KremerMichael/chen-lab-PCB/pictures/diff_amp.jpg

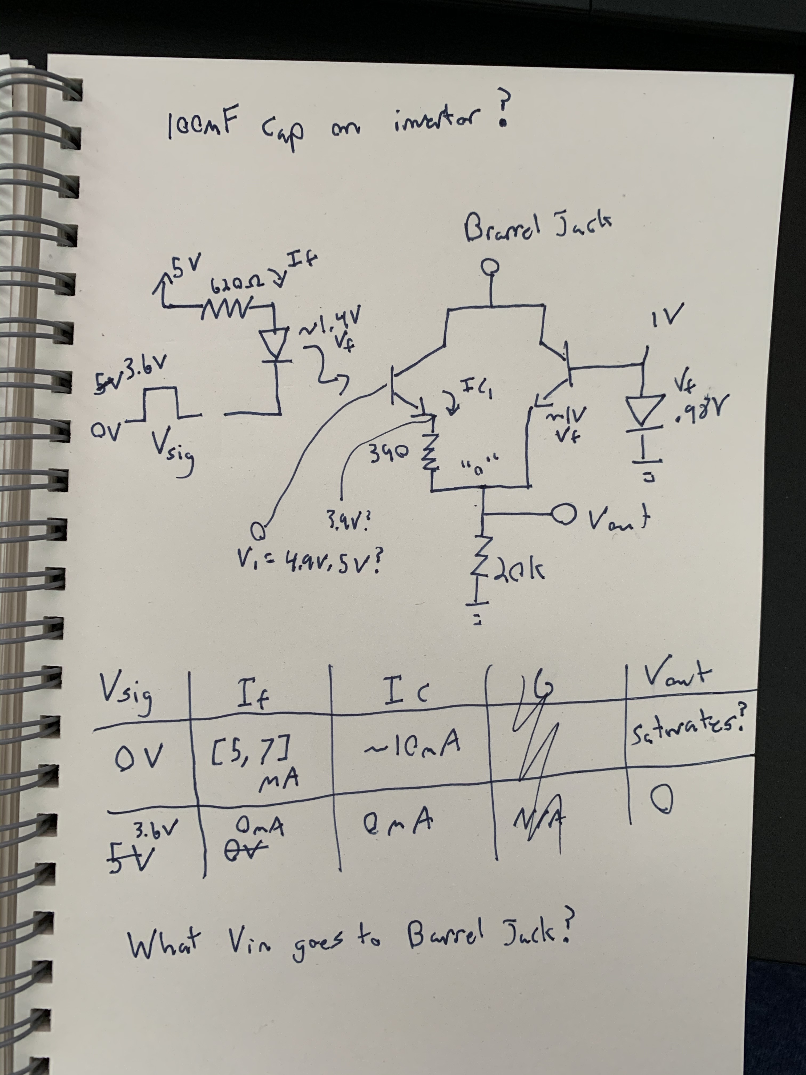
pictures/diff_amp.jpg
