KremerMichael/chen-lab-PCB/pictures/RevA_complete.jpg

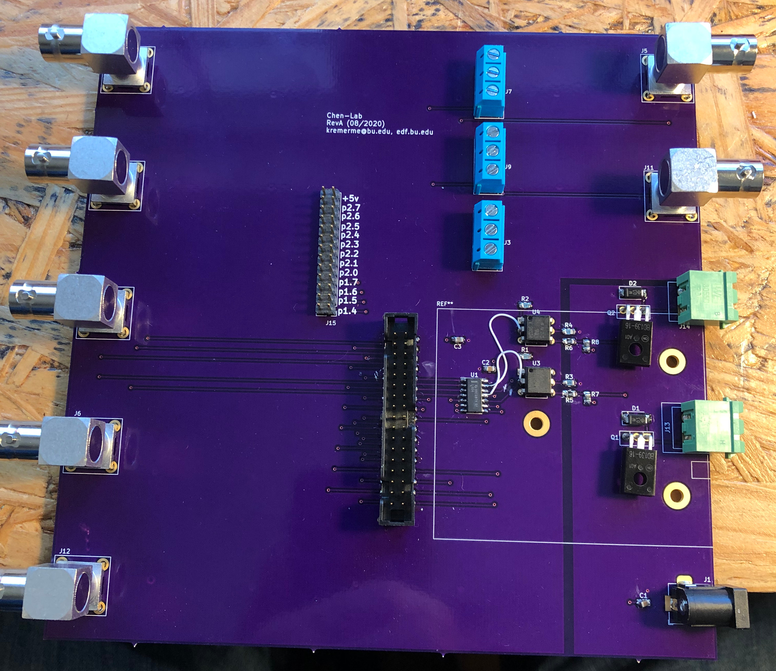
pictures/RevA_complete.jpg
