KremerMichael/chen-lab-PCB/revisions/ECO_for_RevB.md

# Revisions to Rev A

- Update footprint for USB ribbon cable (wider wingspan)
- Replace inverters U1C and U1D (drive J5 and J11) with 2N3906 switch
- Bypass the inverters on the Optiso inputs
- Add DC/DC converter (250mA min) to derive 5V from +12V or +24V
- Change 74LS06 to 74HC04
- Add 1k pull-ups on "SYNC TRIGGER" outputs
- Update silkscreen
