KremerMichael/chen-lab-PCB/documents/3d-views.pdf

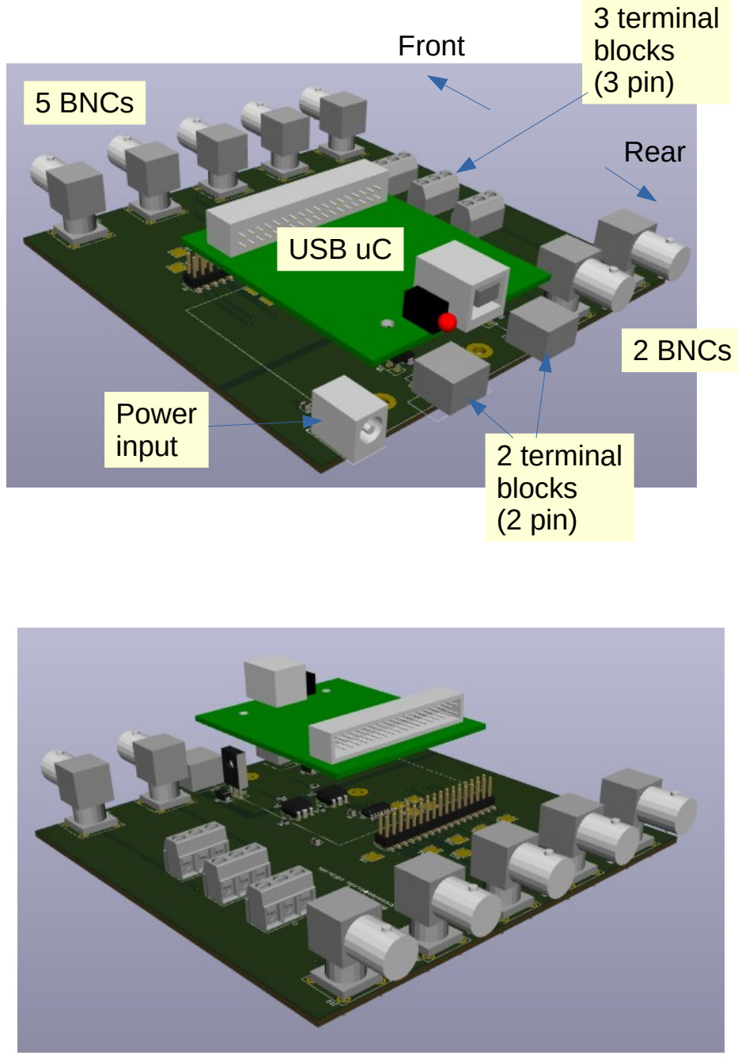
[picture p3: page 1]

5 BNCs

Front

Rear

Power
input | 2 terminal
| blocks
| (2 pin)

2 BNCs

USB uC

3 terminal
blocks
(3 pin)
