KremerMichael/chen-lab-PCB/pictures/Conflicting_Circuits.jpg

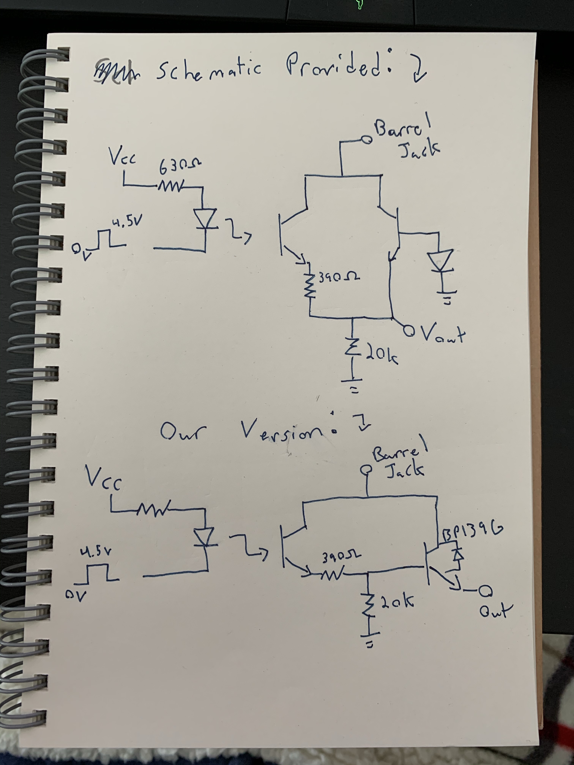
pictures/Conflicting_Circuits.jpg
