KremerMichael/chen-lab-PCB/board-design/3D/CUI_DEVICES_TB002-500-03BE.STL

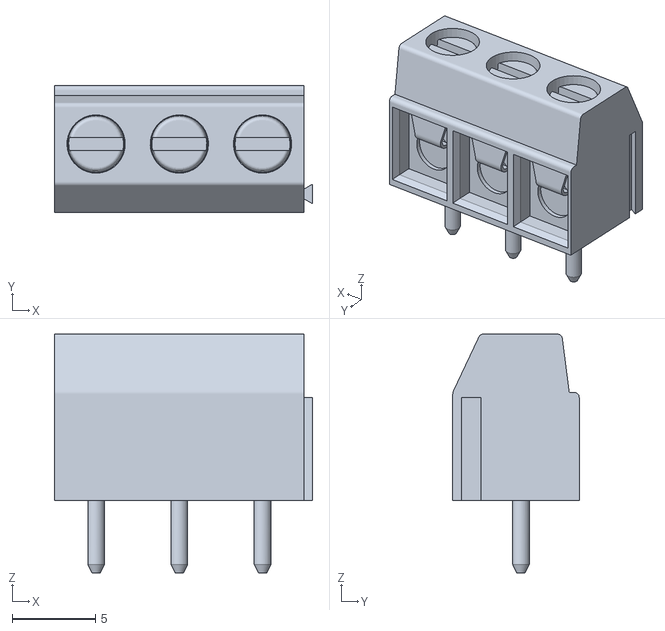
[picture p5: CAD file, 2020-08-26]
board-design/3D/CUI_DEVICES_TB002-500-03BE.STL
15.5 x 7.60 x 14.3
