KremerMichael/chen-lab-PCB/(list of files, cad)

Other CAD files:
enclosure/Front_Cuts.dxf
enclosure/Rear_Cuts.dxf
