KremerMichael/chen-lab-PCB/revisions/solenoid-driver-5v.pdf

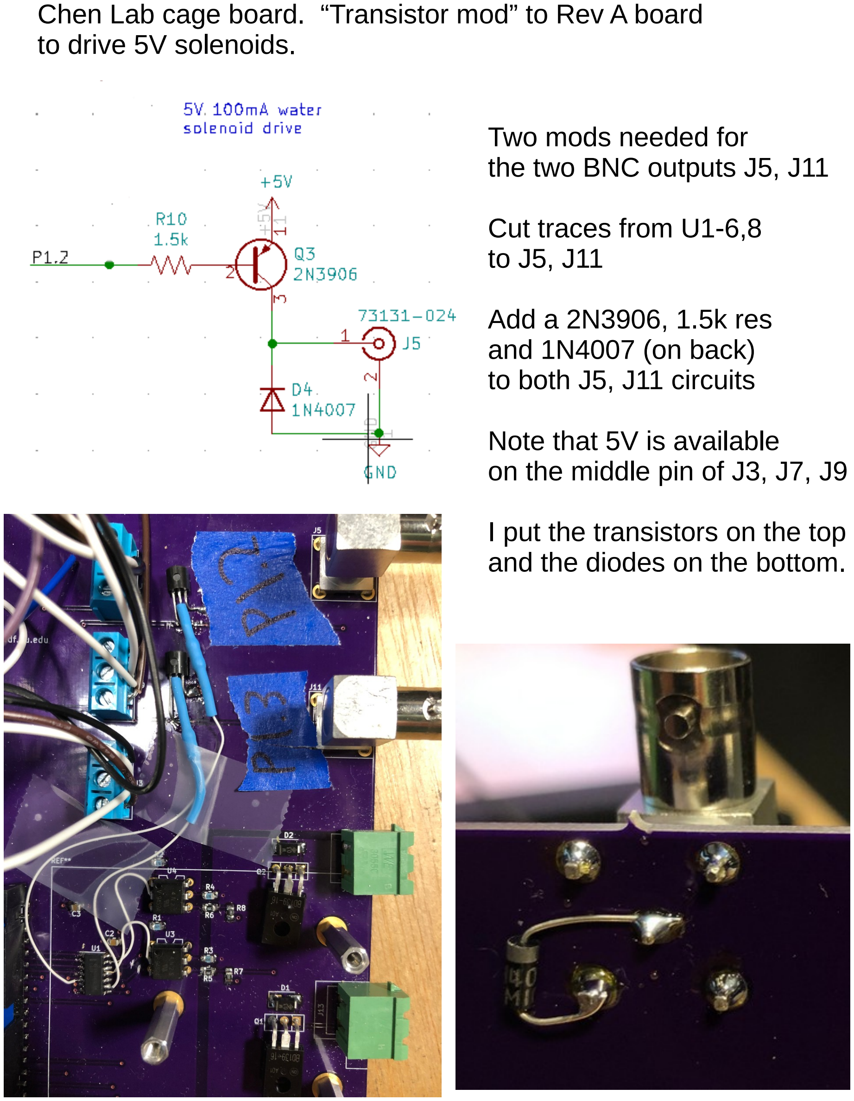
[picture p6: page 1]

Chen Lab cage board. “Transistor mod” to Rev A board to drive 5V solenoids.

Two mods needed for
the two BNC outputs J5, J11

Cut traces from U1-6,8
to J5, J11

Add a 2N3906, 1.5k res
and 1N4007 (on back)
to both J5, J11 circuits

Note that 5V is available
on the middle pin of J3, J7, J9

I put the transistors on the top and the diodes on the bottom.
