KremerMichael/chen-lab-PCB/revisions/solenoid-bypass.pdf

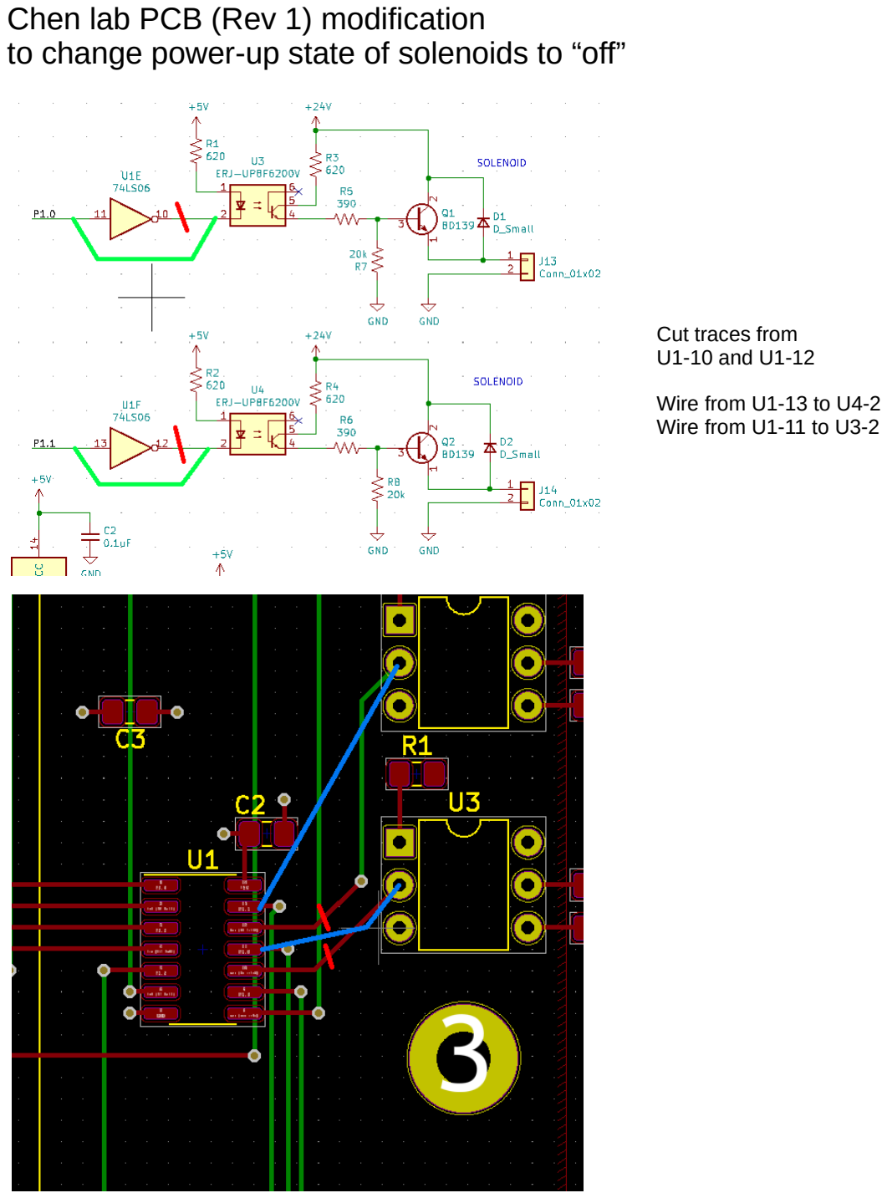
[picture p7: page 1]

Chen lab PCB (Rev 1) modification
to change power-up state of solenoids to “off”

Cut traces from
U1-10 and U1-12

Wire from U1-13 to U4-2
Wire from U1-11 to U3-2
