KremerMichael/chen-lab-PCB/revisions/solenoid_bypass_ECO.png

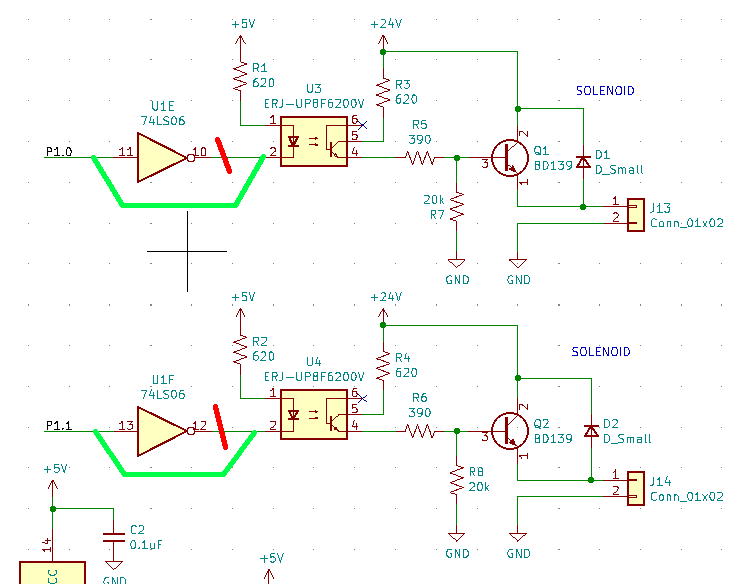
revisions/solenoid_bypass_ECO.png
