KremerMichael/chen-lab-PCB/revisions/solenoid_bypass_ECO_layout.png

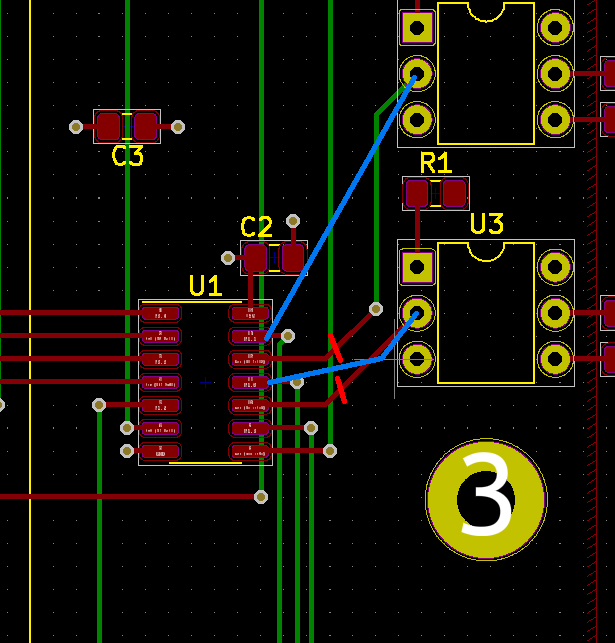
revisions/solenoid_bypass_ECO_layout.png
