KremerMichael/chen-lab-PCB/board-design/cage-board.pdf

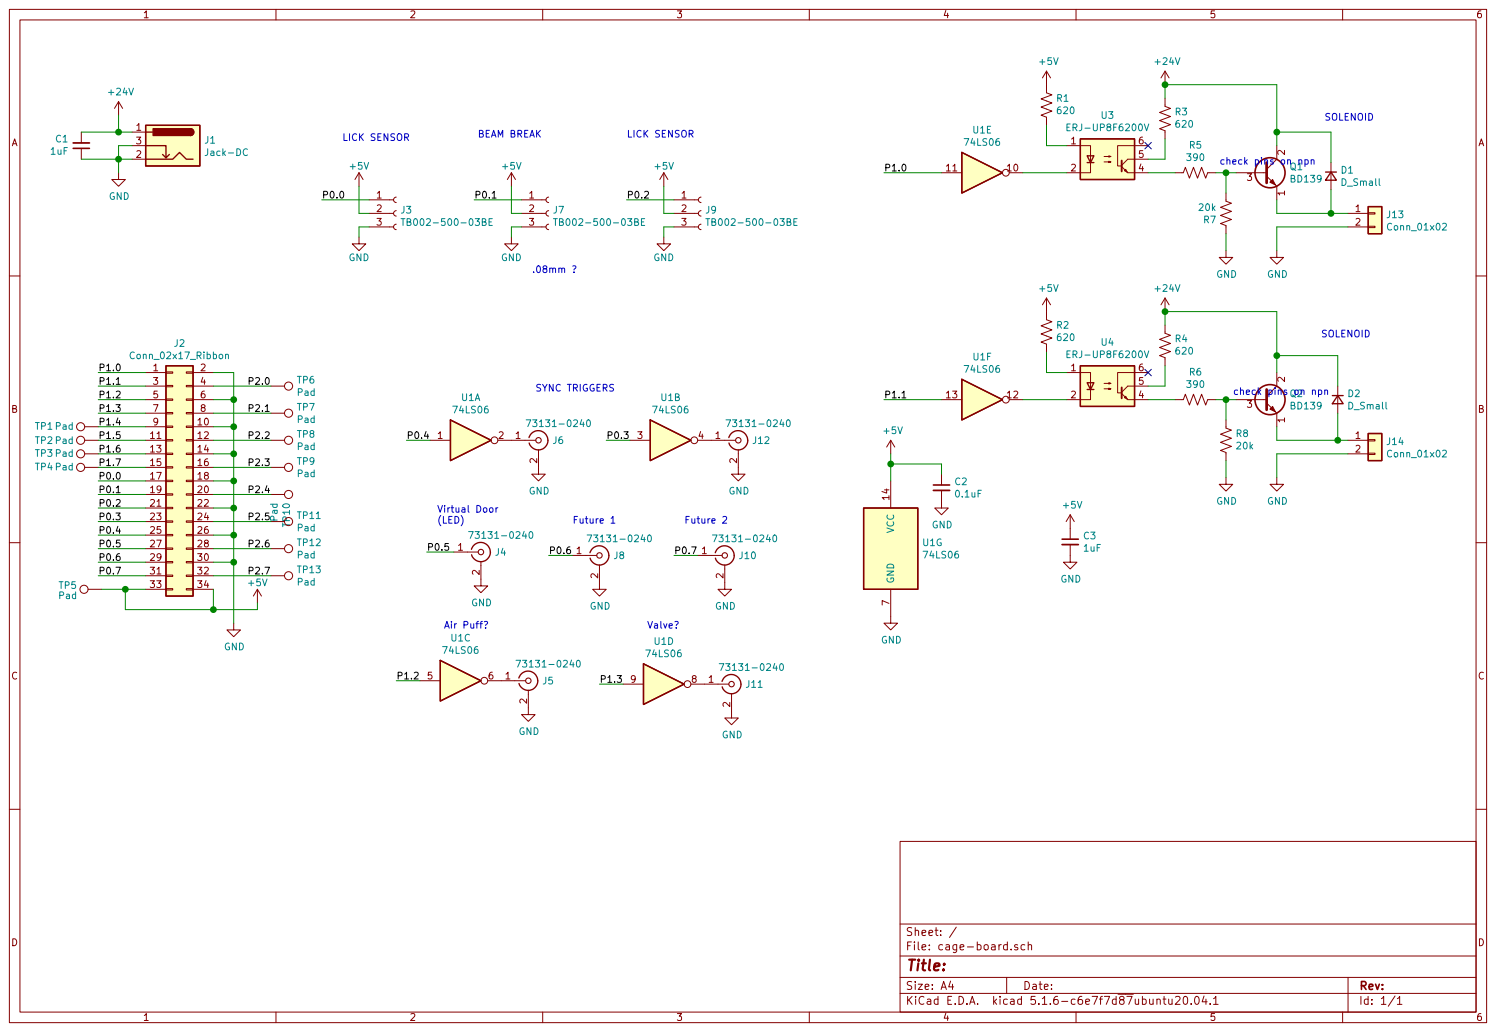
[picture p10: page 1]

check pins on npn

File: cage-board.sch Sheet: /
Id: 1/1 Title:
