KremerMichael/chen-lab-PCB/enclosure/Front_Cuts.pdf

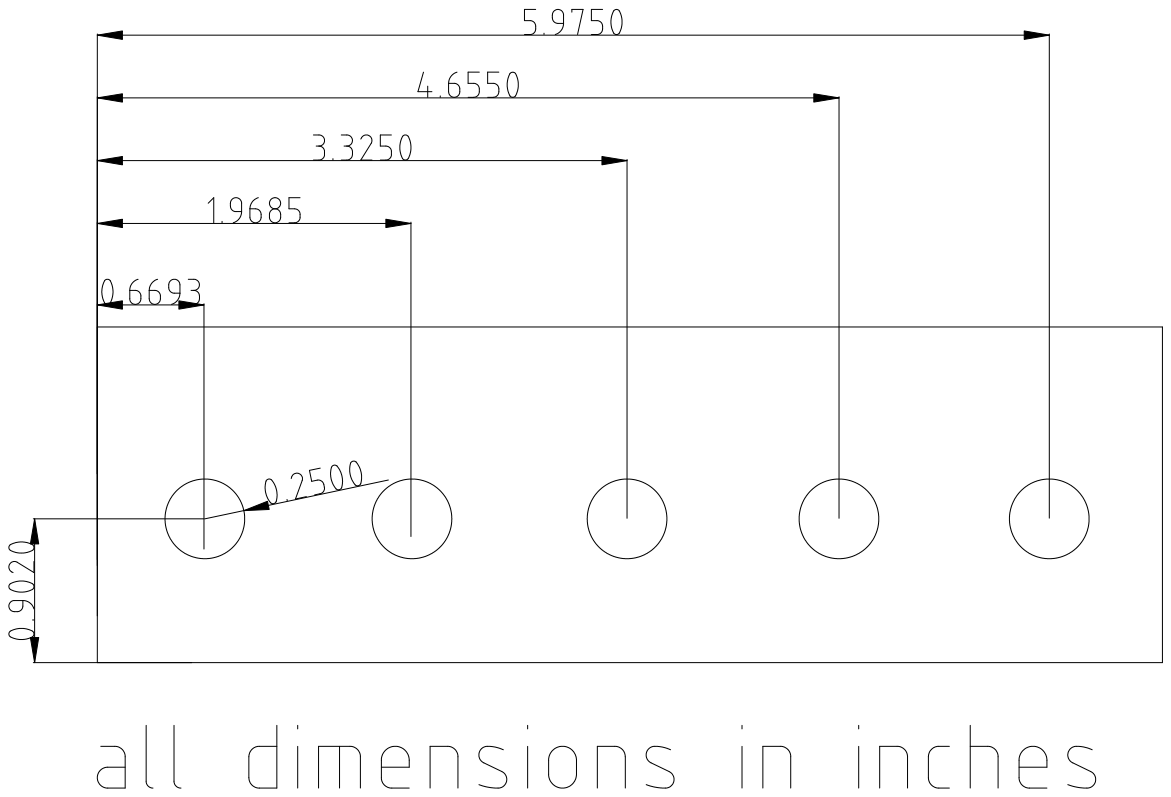
[picture p11: page 1]
