KremerMichael/chen-lab-PCB/enclosure/Rear_Cuts_0.pdf

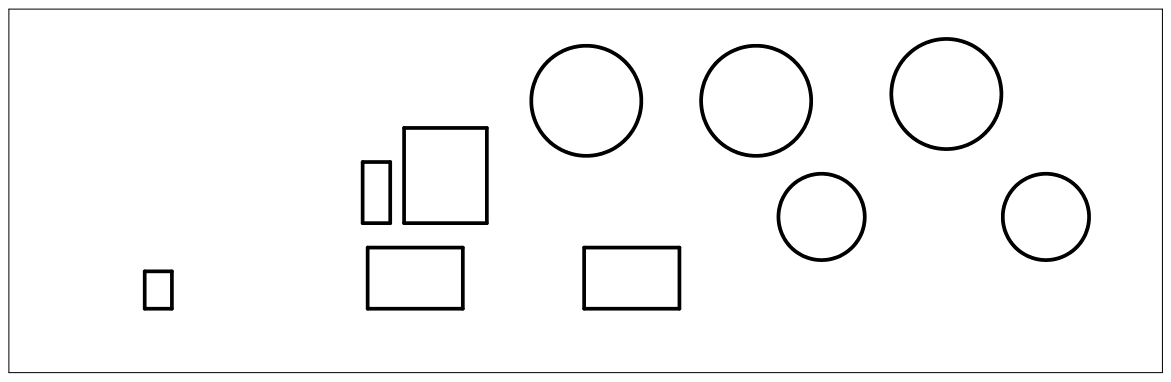
[picture p12: page 1]
