KremerMichael/chen-lab-PCB/enclosure/Rear_Cuts_1.pdf

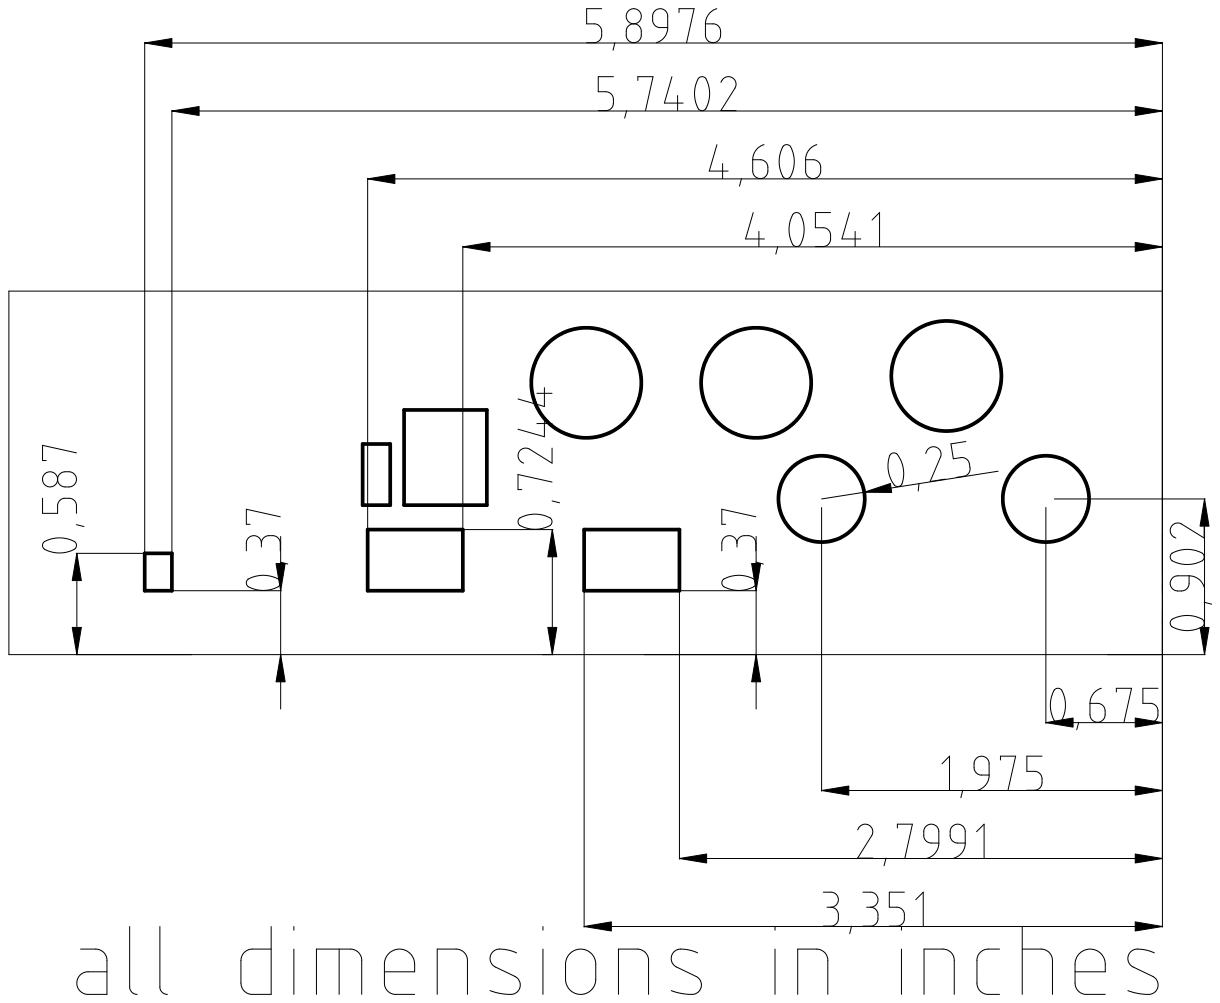
[picture p13: page 1]
