KremerMichael/chen-lab-PCB/enclosure/Rear_Cuts_2.pdf

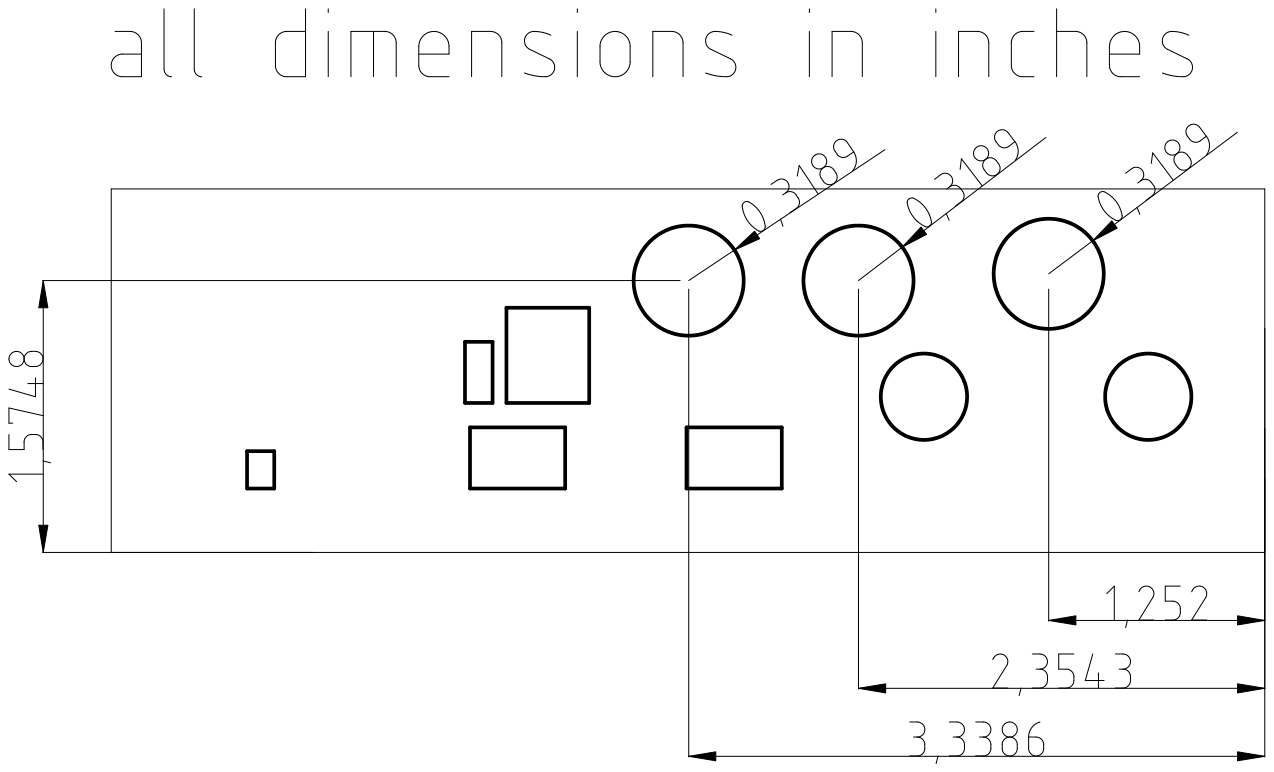
[picture p14: page 1]
