KremerMichael/chen-lab-PCB/enclosure/Rear_Cuts_3.pdf

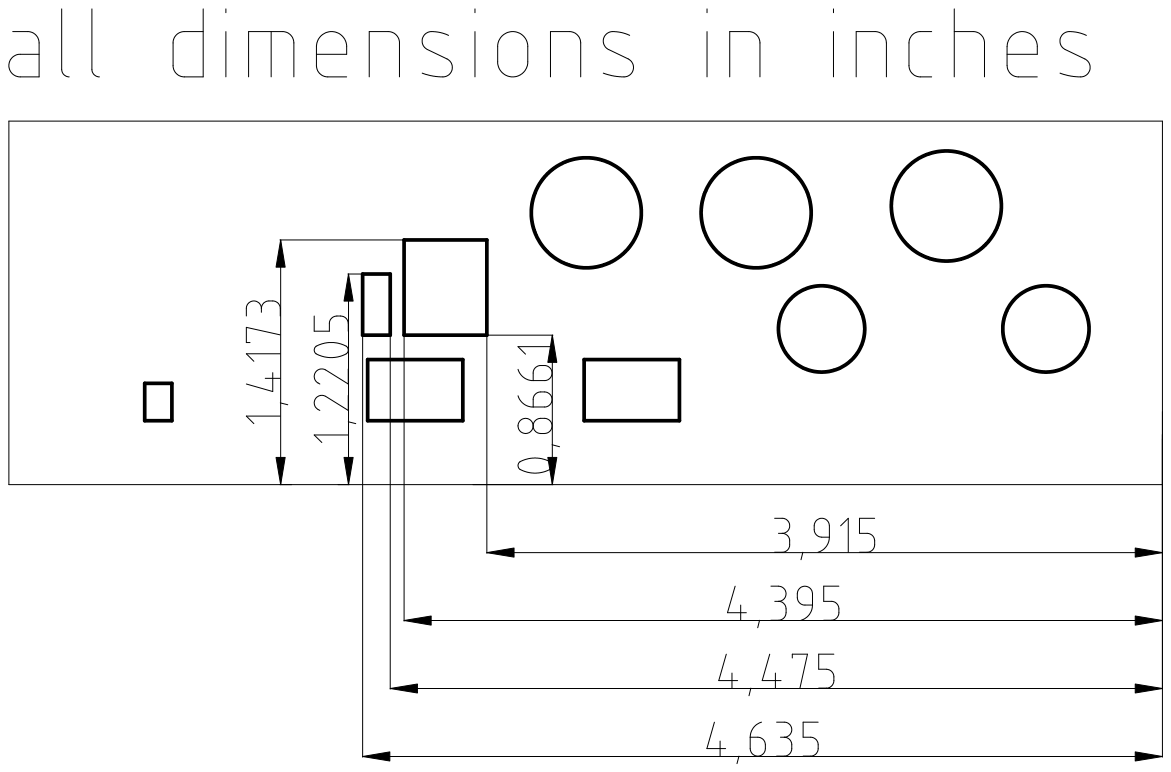
[picture p15: page 1]
