KremerMichael/chen-lab-PCB/board-design/cage-board.kicad_pcb

## KiCad design board-design/cage-board.kicad_pcb (2021-05-31)

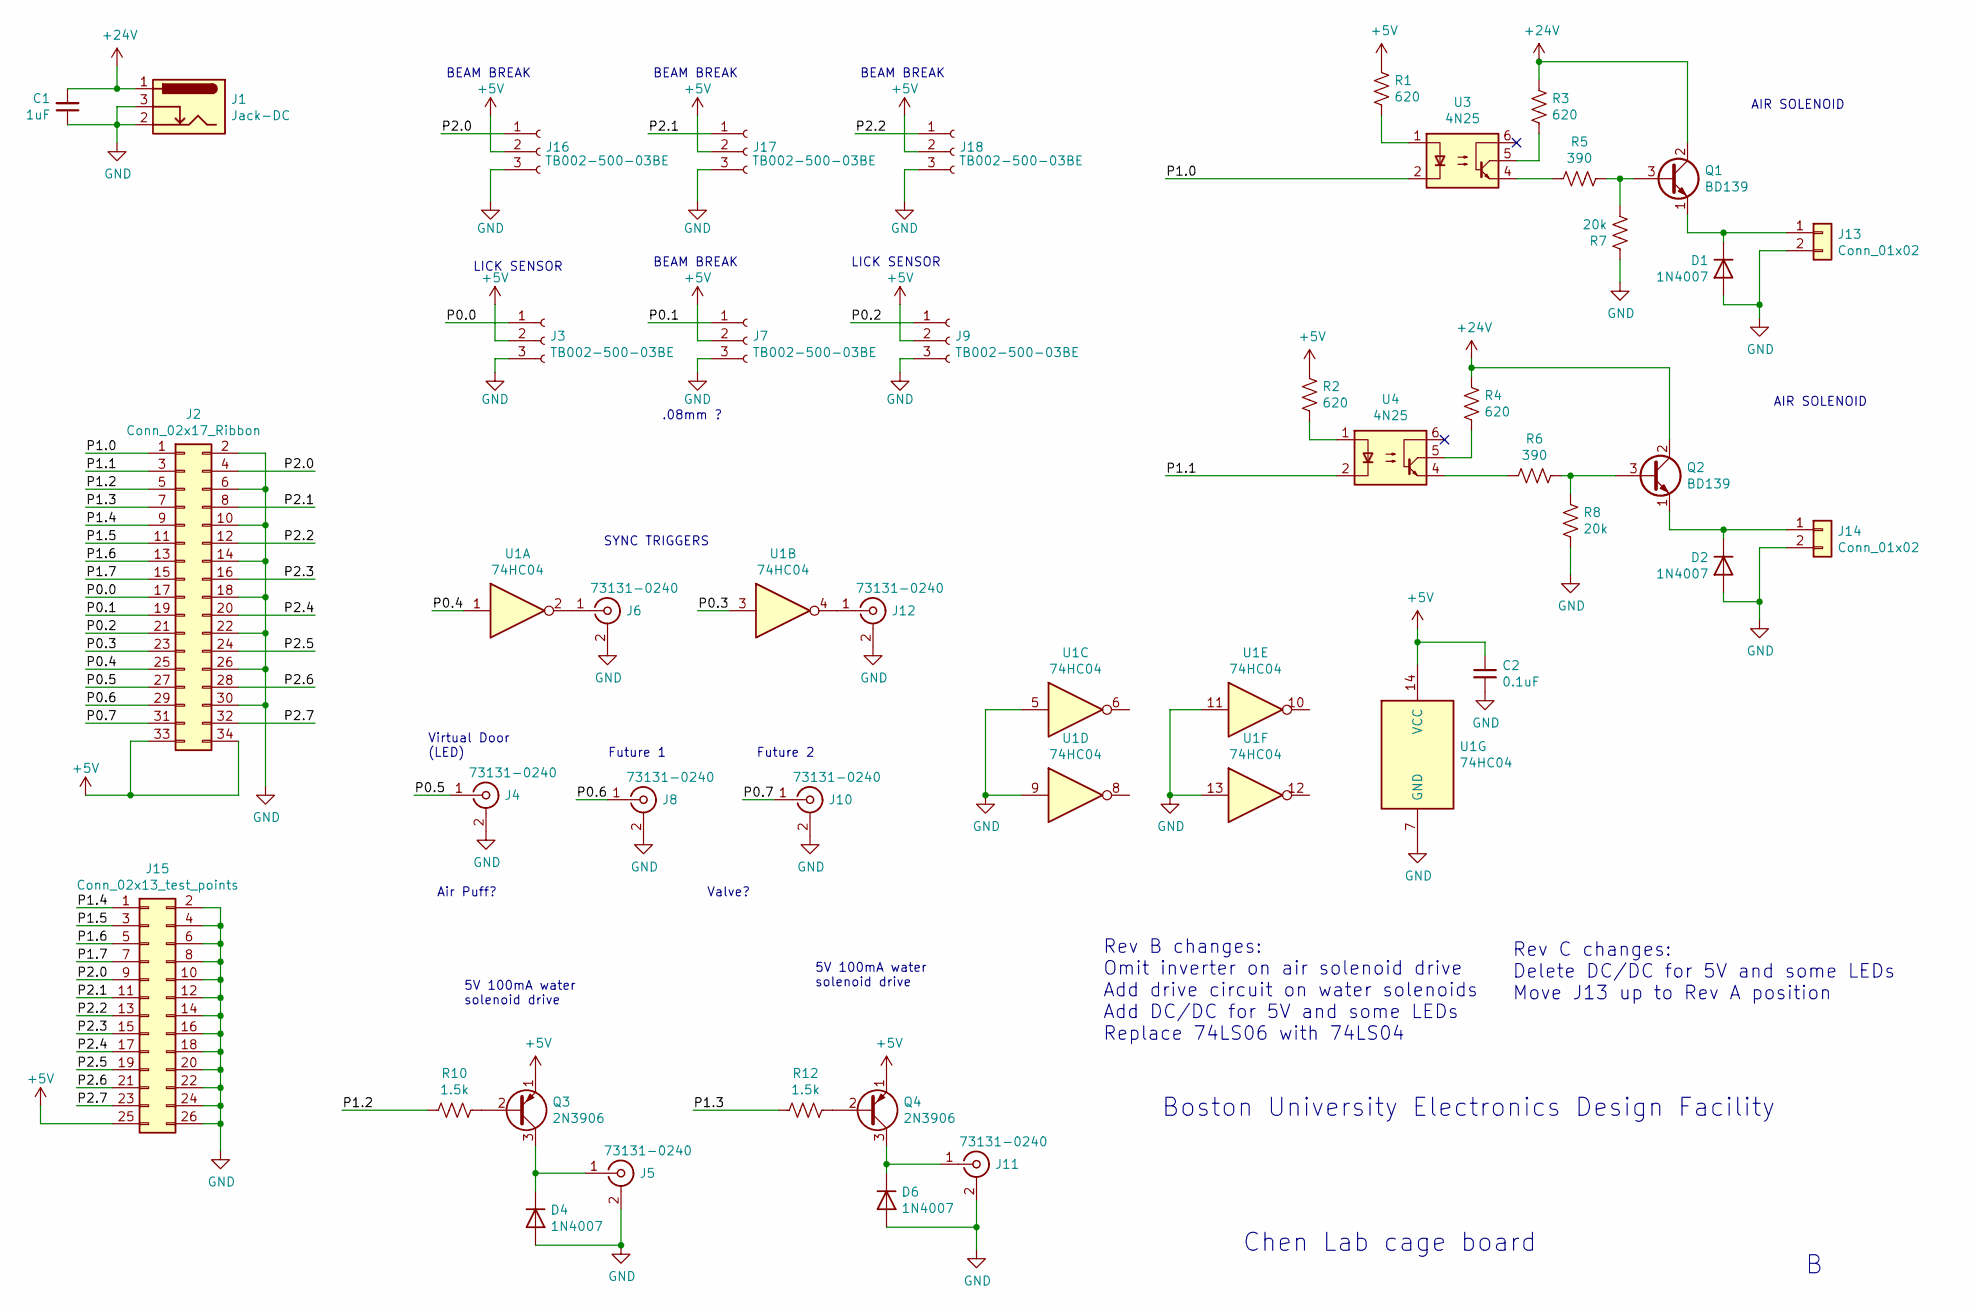
[picture p16: schematic cage-board.sch]

Parts:
C1: 1uF; C_0805_2012Metric_Pad1.15x1.40mm_HandSolder
C2: 0.1uF; C_0805_2012Metric_Pad1.15x1.40mm_HandSolder
D1, D2, D4, D6: 1N4007; D_DO-41_SOD81_P10.16mm_Horizontal
J1: Jack-DC; BarrelJack_Horizontal
J2: Conn_02x17_Ribbon; PinHeader_2x17_P2.54mm_Vertical
J3, J7, J9, J16, J17, J18: TB002-500-03BE; TerminalBlock_bornier-3_P5.08mm
J4, J5, J6, J8, J10, J11, J12: 73131-0240; BNC-Chen
J13, J14: Conn_01x02; TerminalBlock_bornier-2_P5.08mm
J15: Conn_02x13_test_points; PinHeader_2x13_P2.54mm_Vertical
Q1, Q2: BD139; TO-126-3_Vertical
Q3, Q4: 2N3906; TO-92_Inline
R1, R2, R3, R4: 620; R_0805_2012Metric_Pad1.15x1.40mm_HandSolder
R5, R6: 390; R_0805_2012Metric_Pad1.15x1.40mm_HandSolder
R7, R8: 20k; R_0805_2012Metric_Pad1.15x1.40mm_HandSolder
R10, R12: 1.5k; R_0805_2012Metric_Pad1.20x1.40mm_HandSolder
U1: 74HC04; DIP-14_W7.62mm_Socket_LongPads
U3, U4: 4N25; DIP-6_W7.62mm

Connections:
+5V: C2.1, J2.33, J2.34, J3.2, J7.2, J9.2, J15.25, J16.2, J17.2, J18.2, Q3.1 (E), Q4.1 (E), R1.2, R2.2, U1.14 (VCC)
+24V: C1.2, J1.1, Q1.2 (C), Q2.2 (C), R3.2, R4.2
/P0.0: J2.17, J3.1
/P0.1: J2.19, J7.1
/P0.2: J2.21, J9.1
/P0.3: J2.23, U1.3
/P0.4: J2.25, U1.1
/P0.5: J2.27, J4.1 (In)
/P0.6: J2.29, J8.1 (In)
/P0.7: J2.31, J10.1 (In)
/P1.0: J2.1, U3.2
/P1.1: J2.3, U4.2
/P1.2: J2.5, R10.2
/P1.3: J2.7, R12.2
/P1.4: J2.9, J15.1
/P1.5: J2.11, J15.3
/P1.6: J2.13, J15.5
/P1.7: J2.15, J15.7
/P2.0: J2.4, J15.9, J16.1
/P2.1: J2.8, J15.11, J17.1
/P2.2: J2.12, J15.13, J18.1
/P2.3: J2.16, J15.15
/P2.4: J2.20, J15.17
/P2.5: J2.24, J15.19
/P2.6: J2.28, J15.21
/P2.7: J2.32, J15.23
GND: C1.1, C2.2, D1.2 (A), D2.2 (A), D4.2 (A), D6.2 (A), J1.2, J1.3, J2.2, J2.6, J2.10, J2.14, J2.18, J2.22, J2.26, J2.30, J3.3, J4.2 (Ext), J5.2 (Ext), J6.2 (Ext), J7.3, J8.2 (Ext), J9.3, J10.2 (Ext), J11.2 (Ext), J12.2 (Ext), J13.2, J14.2, J15.2, J15.4, J15.6, J15.8, J15.10, J15.12, J15.14, J15.16, J15.18, J15.20, J15.22, J15.24, J15.26, J16.3, J17.3, J18.3, R7.2, R8.1, U1.5, U1.7 (GND), U1.9, U1.11, U1.13
unnamed: D1.1 (K), J13.1, Q1.1 (E)
unnamed: D2.1 (K), J14.1, Q2.1 (E)
unnamed: D4.1 (K), J5.1 (In), Q3.3 (C)
unnamed: D6.1 (K), J11.1 (In), Q4.3 (C)
unnamed: J6.1 (In), U1.2
unnamed: J12.1 (In), U1.4
unnamed: Q1.3 (B), R5.1, R7.1
unnamed: Q2.3 (B), R6.1, R8.2
unnamed: Q3.2 (B), R10.1
unnamed: Q4.2 (B), R12.1
unnamed: R1.1, U3.1
unnamed: R2.1, U4.1
unnamed: R3.1, U3.5
unnamed: R4.1, U4.5
unnamed: R5.2, U3.4
unnamed: R6.2, U4.4

Notes on the sheet:
LICK SENSOR
BEAM BREAK
SYNC TRIGGERS
Virtual Door (LED)
Future 1
Future 2
Air Puff?
Valve?
AIR SOLENOID
.08mm ?
Chen Lab cage board
Boston University Electronics Design Facility
Rev B changes: Omit inverter on air solenoid drive Add drive circuit on water solenoids Add DC/DC for 5V and some LEDs Replace 74LS06 with 74LS04
5V 100mA water solenoid drive
Rev C changes: Delete DC/DC for 5V and some LEDs Move J13 up to Rev A position

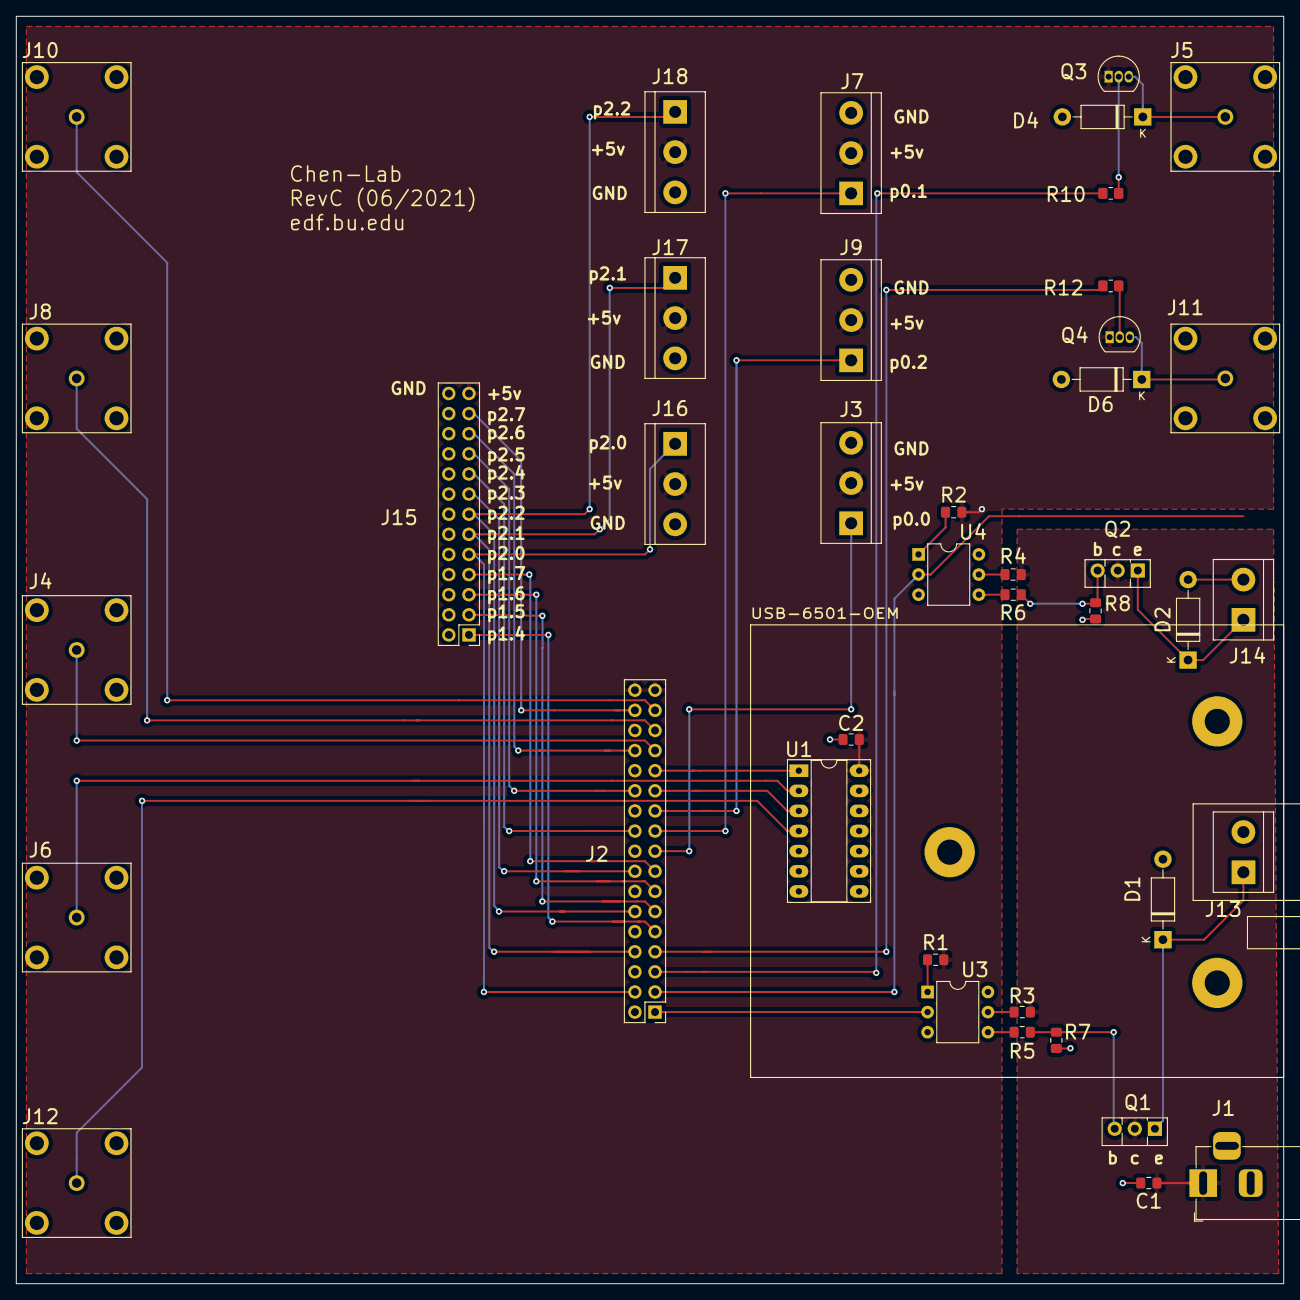
[picture p17: board cage-board.kicad_pcb from above]

Board: 2 copper layers, 160.0 x 160.0 mm, 42 parts (0 on the bottom side), 43 nets.

Other parts of the board:
USB-6501-OEM: usb-6501-oem
