KremerMichael/chen-lab-PCB/(commit log)

2020-08-23 started git repo
    [Draft 2.brd, Draft 2.sch]
2020-08-24 auto push run at Mon 24 Aug 2020 01:14:17 AM EDT
    [Draft 2.brd, Draft 2.sch]
2020-08-24 auto push run at Mon 24 Aug 2020 11:25:32 AM EDT
    [Draft 2.brd]
2020-08-24 auto push run at Mon 24 Aug 2020 11:52:34 AM EDT
    [Draft 2.brd, Draft 2.sch]
2020-08-24 auto push run at Mon 24 Aug 2020 11:58:40 AM EDT
    [Draft 2.csv]
2020-08-24 auto push run at Mon 24 Aug 2020 12:03:22 PM EDT
    [Draft 2.csv]
2020-08-24 auto push run at Mon 24 Aug 2020 03:08:45 PM EDT
    [Draft 2.csv]
2020-08-24 auto push run at Mon 24 Aug 2020 03:10:38 PM EDT
    [Draft 2.brd, Draft 2.sch]
2020-08-25 moving to kicad
    [Chen-Lab.kicad_pcb, Chen-Lab.sch]
2020-08-26 auto push run at Tue 25 Aug 2020 09:51:00 PM EDT
    [Chen-Lab.kicad_pcb, Chen-Lab.sch, cage-board.kicad_pcb, cage-board.sch]
2020-08-26 auto push run at Tue 25 Aug 2020 09:53:13 PM EDT
    [Draft 2.brd, Draft 2.csv, Draft 2.sch, cage-board.kicad_pcb, cage-board.sch]
2020-08-26 Add some 3D models
    [CUI_DEVICES_TB002-500-03BE.STL, bnc.scad, cage-board.kicad_pcb, jack.scad]
2020-08-26 more 3D models
    [cage-board.kicad_pcb, wurth.scad]
2020-08-27 3D model for USB thing
    [usb.scad]
2020-08-27 Add USB board with 3D
    [cage-board.kicad_pcb, cage-board.sch]
2020-08-27 Raise USB board to 0.75in height
    [cage-board.kicad_pcb]
2020-09-02 moved screw terminals and updated test points
    [cage-board.kicad_pcb, cage-board.sch]
2020-09-02 fixing schematic notes
    [cage-board.sch]
2020-09-02 added BoM
    [cage-board_RevA.csv]
2020-09-02 fixing 3d models hopefully
    [cage-board.kicad_pcb, cage-board.sch]
2020-09-03 added inch to board length and spaced out connectors more
    [cage-board.kicad_pcb]
2020-09-09 adding dimensions for protocase
    [cage-board.kicad_pcb]
2020-09-09 working on finishing enclosure
2020-09-16 working on resizing board
    [cage-board.kicad_pcb]
2020-09-17 working on fixing connectors
    [cage-board.kicad_pcb]
2020-09-17 moving stuff around and working on enclosure
    [cage-board.kicad_pcb]
2020-09-20 Finished cuts for panels
    [Front_Cuts.dxf, Rear_Cuts.dxf]
2020-09-23 adding BoM's for one off parts
    [enclosure.csv, usb.csv]
2020-09-24 fixing BoM
    [cage-board_RevA.csv]
2020-12-02 Rev B mods
    [cage-board.sch]
2020-12-02 Rev B changes to sch done?
    [cage-board.sch]
2021-01-05 updating schematic, and moving PCB layout forward to RevB
    [cage-board.csv, cage-board.kicad_pcb, cage-board.sch]
2021-04-09 auto push run at Fri Apr 9 11:10:50 EDT 2021
    [cage-board.kicad_pcb, cage-board.sch]
2021-04-09 driver doc
2021-04-09 auto push run at Fri Apr 9 12:23:24 EDT 2021
    [cage-board.kicad_pcb, cage-board.sch, cage-board_RevB.csv]
2021-04-16 changin to right angle LEDs, fixing terminal blocks, fixing DC-DC footprint
    [cage-board.kicad_pcb, cage-board.sch, cage-board_RevB.csv]
2021-04-16 fixing 5v led
    [cage-board.kicad_pcb]
2021-04-23 auto push run at Fri Apr 23 09:52:58 EDT 2021
    [cage-board.kicad_pcb]
2021-04-23 new BoM
    [cage-board_RevB.csv]
2021-05-31 all done except moving J13
    [cage-board.kicad_pcb, cage-board.sch]
2021-05-31 Final Rev C layout
    [cage-board.kicad_pcb]
2021-05-31 Candidate Rev C gerbers
2021-05-31 Restore USB board footprint, tweak silkscreen
    [cage-board.kicad_pcb]
2021-06-09 Add Rev C BOM
    [cage-board.csv]
2021-06-09 Final Rev C gerbers
2021-06-09 Fix a couple of BOM issues
    [cage-board.csv, cage-board.sch]
